micah-breitenstein/MOCO-jib/MILESTONES.md

# Project Milestones

## Milestone 1: Speed Control Stabilization - COMPLETE
Date: 2026-04-16

Status:
- Speed issue is fixed and validated in field testing.

What was stabilized:
- Drone/axis speed behavior now responds consistently.
- Core legacy/original feature set remains functional.
- Timelapse and Flowlapse tuning can proceed on a stable speed baseline.

Why this matters:
- This milestone removes the primary blocker to reliable motion tuning.
- Future work can focus on refinement (smoothing, sync, UX) instead of baseline control recovery.
