micah-breitenstein/MOCO-jib/tests/test_motor_control.cpp

#include <cassert>
#include <cstdint>
#include <iostream>
#include <map>

// Mock motor pin state tracking
struct MotorPinState {
  uint8_t pin;
  int pulseCount;      // Number of pulses sent
  uint8_t lastValue;
  bool isPulseEdge; // Track if we're using edge-triggered pulses
  
  MotorPinState() : pin(0), pulseCount(0), lastValue(0), isPulseEdge(false) {}
  MotorPinState(uint8_t p) : pin(p), pulseCount(0), lastValue(0), isPulseEdge(false) {}
};

std::map<uint8_t, MotorPinState> motorPins;

void mockDigitalWrite(uint8_t pin, uint8_t value) {
  if (motorPins.find(pin) == motorPins.end()) {
    motorPins[pin] = MotorPinState(pin);
  }
  
  MotorPinState& state = motorPins[pin];
  
  // Detect pulse edge: transition from LOW to HIGH or HIGH to LOW (but not same value twice)
  if (state.lastValue != value) {
    // Count complete pulses: LOW->HIGH->LOW or HIGH->LOW->HIGH
    // For simplicity, we'll count each transition; a full pulse is 2 transitions
    state.pulseCount++;
  }
  
  state.lastValue = value;
}

// Test: Motor control uses edge-triggered pulses, not level-driven pins
void test_motor_control_is_pulse_based() {
  motorPins.clear();
  
  uint8_t panSpeedUp = 10;
  
  // Simulate pulse-based tier stepping (correct behavior)
  // Pulse up: HIGH then LOW
  mockDigitalWrite(panSpeedUp, 1);  // HIGH
  mockDigitalWrite(panSpeedUp, 0);  // LOW
  
  // Should have 2 transitions = 1 complete pulse
  assert(motorPins[panSpeedUp].pulseCount == 2);
  assert(motorPins[panSpeedUp].lastValue == 0);
  
  std::cout << "✓ Motor control uses edge-triggered pulses (not level-driven)\n";
}

// Test: Tier increments via discrete pulses
void test_tier_stepping_via_pulses() {
  motorPins.clear();
  
  uint8_t speedUpPin = 10;
  uint8_t currentTier = 1;
  uint8_t targetTier = 3;
  
  // Simulate stepping from tier 1 to tier 3 (2 increments = 4 transitions)
  while (currentTier < targetTier) {
    mockDigitalWrite(speedUpPin, 1);  // HIGH
    mockDigitalWrite(speedUpPin, 0);  // LOW
    currentTier++;
  }
  
  // 2 pulses = 4 transitions
  assert(motorPins[speedUpPin].pulseCount == 4);
  assert(currentTier == 3);
  
  std::cout << "✓ Tier stepping uses discrete pulses (not cumulative levels)\n";
}

// Test: No level-driven pin state holding
void test_no_level_driven_pin_holding() {
  motorPins.clear();
  
  uint8_t speedUpPin = 10;
  
  // Bad behavior: holding pin HIGH for duration (level-driven)
  mockDigitalWrite(speedUpPin, 1);  // HIGH
  mockDigitalWrite(speedUpPin, 1);  // HIGH (repeated - this is bad)
  
  // Good behavior: should pulse HIGH then LOW
  mockDigitalWrite(speedUpPin, 0);  // LOW
  
  // If we're level-driven, this would accumulate state
  // Verify pulse count shows we're not holding levels
  assert(motorPins[speedUpPin].lastValue == 0);  // Currently LOW (idle)
  
  std::cout << "✓ Motor pins don't hold level states (pulse-based only)\n";
}

// Test: Bounce tier tracking prevents speed drift
void test_bounce_per_axis_tier_tracking() {
  motorPins.clear();
  
  // Simulate bounce mode with per-axis tier tracking
  uint8_t bounceSwingTier = 1;
  uint8_t bouncePanTier = 1;
  
  // Pulse swing up to tier 2
  mockDigitalWrite(12, 1);  // swing speed up
  mockDigitalWrite(12, 0);
  bounceSwingTier++;
  
  // Pulse pan up to tier 2
  mockDigitalWrite(14, 1);  // pan speed up
  mockDigitalWrite(14, 0);
  bouncePanTier++;
  
  assert(bounceSwingTier == 2);
  assert(bouncePanTier == 2);
  
  // Simulate second bounce cycle - tiers should NOT drift down
  int swing_pulses_this_cycle = motorPins[12].pulseCount;
  int pan_pulses_this_cycle = motorPins[14].pulseCount;
  
  // First cycle had 2 pulses each (HIGH->LOW = 2 transitions)
  assert(swing_pulses_this_cycle == 2);
  assert(pan_pulses_this_cycle == 2);
  
  std::cout << "✓ Bounce per-axis tier tracking prevents drift\n";
}

int main() {
  std::cout << "\n=== Motor Control Tests ===\n";
  
  test_motor_control_is_pulse_based();
  test_tier_stepping_via_pulses();
  test_no_level_driven_pin_holding();
  test_bounce_per_axis_tier_tracking();
  
  std::cout << "\n✓ All motor control tests passed\n\n";
  return 0;
}
