micah-breitenstein/MOCO-jib/(commit log)

2026-03-20 Initial commit: camera rig sketches and README
2026-03-21 Clean up PS2 pin define formatting
2026-03-21 camelCase rename: swingLeft, swingRight; fix Button Settings header
2026-03-21 camelCase rename: pan, lift, tilt, focus, switches, timelapse vars
2026-03-21 refactor: use constexpr uppercase DIP switch pin constants
2026-03-21 refactor: use bool DIP switch state flags
2026-03-21 refactor: rename reverse DIP switch flags
2026-03-21 refactor: simplify setup pin initialization
2026-03-21 Refactor: extract axis speed control into helper function
    - Add handleAxisSpeedControl() to manage paired-axis button control
    - Preserves ButtonReleased() edge-triggered semantics
    - Consolidates R1/R2 (lift+tilt) and L1/L2 (pan+swing) speed controls
    - Improves readability and maintainability
2026-03-21 Add setDirectionalOutput() helper for reversal logic
    - Consolidates the reversal if-pattern into reusable function
    - Takes reversal flag, normal pin, reversed pin, and desired state
    - Makes reversal logic more readable and maintainable
2026-03-21 Step 4: Extract solo mode handler function
    Adds handleSoloDirectionalMode() to consolidate SELECT+button activation/release pattern
    - Eliminates separate if blocks for each solo direction
    - Manages mode state and pin control in one function
    - Reduces swing solo mode code from 22 lines to 2 function calls
2026-03-21 Step 5: Extract combined mode handler for dual-axis control
    Adds handleCombinedDirectionalMode() to manage button+release for paired axes
    - Consolidates activate/release for 2 axis pairs (swing+pan, or lift+tilt)
    - Manages solo mode check and motion state
    - Reduces swing+pan combined code from 30 lines to 2 function calls
2026-03-21 Step 27: Add detailed timelapse mode Serial.println labels
2026-03-21 Step 29: Restore timelapse mode comments inside switch cases
2026-03-21 Step 31.3: Extract shared bounce stage 0 helpers
2026-03-21 Step 31.4: Extract shared bounce stage 1 helper
2026-03-21 Step 32: Convert bounce MOCO to non-blocking millis state machine
2026-03-21 Refactor NANO_slave_1_SWING: const pins, STAGE_DELAYS array, stepMotor/updateSpeedStage helpers, remove unused vars, add comments
2026-03-21 Refactor NANO_slave_2_PAN: const pins, STAGE_DELAYS array, stepMotor/updateSpeedStage/applySpeedAdjust helpers, add header comment
2026-03-21 Refactor NANO_slave_3_LIFT: const pins, STAGE_DELAYS array, stepMotor/updateSpeedStage helpers, remove unused vars and dead potentiometer, add comments
2026-03-21 Refactor NANO_slave_4_TILT: const pins, STAGE_DELAYS array, stepMotor/updateSpeedStage/applySpeedAdjust helpers, add header comment
2026-03-21 Refactor NANO_slave_5_FOCUS: const pins, STAGE_DELAYS array, stepMotor/updateSpeedStage helpers, add comments
2026-03-22 Step 40: Add stepDist controller adjustment and clamp to 20..150 ms
2026-03-23 Step 51: Settings replay chains interval then stepDist rumble patterns
2026-03-23 Step 52: Print boot-time interval and stepDist to Serial on startup
2026-03-23 Step 54: Print descriptive mode label to Serial on timelapse and bounce start
2026-03-23 Step 59: Add Serial.begin(9600) to setup — Serial output was never initialized
2026-03-23 Step 60: Fix detectControllerType to use println (were missing newlines)
2026-03-23 Step 61: Print timelapse mode label only on first cycle, not every interval
2026-03-23 Step 63: Fix handleFocusAxis duplicate pin — SQUARE and CIRCLE each control one speed pin
2026-03-23 Step 71: Add VS Code build task using arduino-cli for Mega master
2026-03-23 Step 72: Add VS Code Arduino extension recommendations
2026-03-23 Add per-axis deadband calibration for drone stick control
2026-03-23 Print drone tuning profile values at boot
2026-03-23 Print drone modifier and tier threshold config at boot
2026-03-24 Add drone-mode Flowlapse waypoint preview and safe capture run
2026-03-24 Document Flowlapse drone controls and safety behavior
2026-03-24 Tune Flowlapse for safer night motion profile
2026-03-24 Reject near-duplicate Flowlapse waypoints by minimum separation
2026-03-24 Add L1+R1 Flowlapse waypoint clear combo in drone mode
2026-03-24 Add periodic Flowlapse capture progress telemetry
2026-03-24 Print Flowlapse tuning constants in boot serial profile
2026-03-24 Use L2+R2 to delete last Flowlapse waypoint instead of clearing course
2026-03-24 Make L2+R2 a two-step Flowlapse undo then delete action
2026-03-24 README: promote Flowlapse to top-level feature; update L3 button table entry
2026-03-24 Print waypoint axis positions to serial on L3 record
2026-03-24 Add FLOWLAPSE_LOOP_CAPTURE constant to auto-restart capture on completion
2026-03-24 Print DIP axis reversal state to serial at boot
2026-03-24 README: document 5 new Flowlapse features from recent commits
2026-03-24 Add Flowlapse waypoint jog: D-pad left/right steps through waypoints in ready states
2026-03-24 Add FLOWLAPSE_WAYPOINT_DWELL_MS: settle pause at each waypoint before camera trigger
2026-03-24 Make Flowlapse dwell controller-adjustable: SELECT+D-pad UP/DOWN in drone mode (250ms steps, 0-5000ms)
2026-03-24 README: document Flowlapse waypoint jog and controller-adjustable dwell controls
2026-03-24 Improve Flowlapse jog feedback with waypoint current/total indexing
2026-03-24 Add FLOWLAPSE_PREVIEW_SPEED_SCALE to run preview slower than capture
2026-03-24 Add ETA seconds to periodic Flowlapse capture progress logs
2026-03-24 Add L3 hold quick reset in drone mode and document new Flowlapse upgrades
2026-03-25 Add Catmull-Rom curved path mode for Flowlapse capture
2026-03-27 fix: turn off LED_BUILTIN at end of stepMotor() on all Nano slaves
    LED was only cleared at the top of loop(), so at high motor speeds it
    burned solid instead of blinking per pulse. Adding the LOW write at the
    end of stepMotor() makes each step a discrete visible blink, which helps
    distinguish 'moving fast' from a stall or other issue.
2026-03-30 fix: make shoulder speed outputs level-driven on Mega
    Write L1/L2/R1/R2 speed pins from live button state each loop instead of
    relying on ButtonReleased edges. This prevents stale HIGH outputs and
    restores reliable rising-edge speed cycling on Nano slaves.
2026-03-30 fix: make focus wheel outputs level-driven on Mega
    Drive focus direction and speed pins from live button state each loop
    instead of relying on release-edge events. This prevents stale outputs
    and restores responsive focus control after refactor.
2026-03-30 fix: make swing/lift coupled follow outputs level-driven
    Update solo and combined directional handlers to drive outputs from live
    button state each loop instead of release-edge transitions. This avoids
    stale direction pins that can break pan-follow during swing and tilt-
    follow during lift.
2026-03-30 refactor: make generic button direction helper level-driven
    Update handleButtonDirection() to derive pin outputs from live button state
    instead of release-edge events for consistency with other hardened input
    paths.
2026-03-30 fix: allow START to recover from stuck Flowlapse preview
    during Drone Flowlapse, pressing START while preview is running now
    forces preview completion and transitions to READY_FOR_CAPTURE. Added
    README notes describing this recovery path and follow-up START behavior.
2026-04-02 fix: restore shoulder and focus speed button behavior
2026-04-02 hardening: neutralize motor outputs on controller early-exit paths
2026-04-02 feat: add START+R1 return-to-start combo for Flowlapse
2026-04-02 feat: add pause/resume Flowlapse capture via START button
2026-04-02 docs: document pause/resume Flowlapse capture feature
2026-04-02 feat: add runtime ping-pong loop mode toggle for Flowlapse
2026-04-02 feat: add runtime acceleration profile cycling for Flowlapse
2026-04-02 docs: clarify onboard LED is single-color and RGB requires external LED
2026-04-07 Fix: Convert speed control outputs from edge-triggered to live-state polling
    - handleAxisSpeedControl(): Changed from Button/ButtonReleased paired logic to continuous state polling
    - handleFocusAxis(): Changed focus speed pins (SQUARE/CIRCLE) to live-state output
    - Reason: ButtonReleased() events can be missed if loop execution is skipped by early returns, causing speed pins to latch HIGH indefinitely
    - Solution: Write output state every loop based on current button state, eliminating event-dependency
    - Result: Speed control now reliable regardless of execution flow paths
2026-04-07 Refactor: Convert mode selection buttons from edge-triggered to live-state tracking
    - updateTimelapseModeSelection(): Track SELECT button state each loop, detect falling edge
    - updateBounceModeSelection(): Track START button state each loop, detect falling edge
    - Added global bool variables: lastSelectButtonState, lastStartButtonState
    - Reason: ButtonReleased() events can be missed if loop execution is skipped by early returns
    - Solution: Detect edges from live button state, mirroring pattern from speed control fix
    - Result: Mode selection now reliable regardless of loop execution flow
2026-04-07 Refactor: Eliminate remaining ButtonReleased event-dependencies across all button handlers
    Refactored 8 handlers: TRIANGLE, L3, PAD_RIGHT, PAD_LEFT, SELECT(drone), START(drone), R3, and bounce L3
    All button handlers now use live-state polling with edge detection. Immune to early-return path skipping.
    Added documentation to README explaining the architectural decision and benefits.
2026-04-07 Stop tracking ESP32-S3 build artifacts
2026-04-08 Fix Mega speed control handling and startup stage defaults
2026-04-09 Document Mega to ESP32-S3 wiring
2026-04-10 ESP32-S3: add temporary controller-error display test hook
2026-04-10 README: add explicit ESP UART RX/TX pin mapping
2026-04-10 ESP32-S3: move display UART to GPIO40/41
2026-04-10 Add ESP32-S3 matrix status node and integrate timeout-based status recovery
2026-04-10 README: update final display and matrix UART pin mapping
2026-04-11 Document optional ESP32-S3 hardware in requirements
2026-04-11 Add ESP32-S3 display entry to repository structure
2026-04-11 Replace RGB LED note with ESP32-S3 matrix recommendation
2026-04-11 Clarify dual ESP32-S3 RGB matrices in feedback layer
2026-04-12 Tidy display UART parser and direction-change logging
2026-04-12 Improve drone UI responsiveness and fix flowlapse capture progress stall
2026-04-12 Improve flowlapse UI/state handling and progress logging
2026-04-12 Add robust flowlapse display telemetry and preview indicators
2026-04-12 Improve drone modifier indicators and flowlapse status telemetry
2026-04-13 Fix speed button handling and tune diagnostic logging
2026-04-13 Refine flowlapse preview UI and L2 boost visibility
2026-04-13 Add PS2 and Mega wiring photo references to README
2026-04-13 Add README-renderable PS2 wiring images
2026-04-14 Tighten README mission and background copy
2026-04-14 Tighten jib letter spacing in lowercase logo
2026-04-14 Tighten jib tracking to match MOCO spacing
2026-04-14 Switch README logo to v14 cache-busting asset
2026-04-14 Switch README to non-oqo logo filename v15
2026-04-14 Clarify VS Code and Arduino CLI prerequisites in README
2026-04-14 Expand RGB Matrix section: UART config, full state/color table
2026-04-14 Add full UART message table for display firmware; fix baud rate typo
2026-04-14 Correct button polling architecture coverage — speed/focus still use ButtonReleased
2026-04-14 Correct ButtonReleased risk assessment: focus direction is real risk, speed pulse is harmless
2026-04-14 Document history of speed button hold-HIGH refactor in bcea0b5
2026-04-17 WIP: touchscreen settings menu - buttons, colors, theme fixes in progress
2026-04-18 fix: correct display color mapping (BGR order + COLOR_16_SWAP)
    - Set LCD_RGB_ELEMENT_ORDER_BGR (display expects BGR, not RGB)
    - Enable CONFIG_LV_COLOR_16_SWAP in sdkconfig (SPI byte order fix)
    - Disable all LVGL themes (default, basic, mono) — not needed
    - Kill theme on display registration as belt-and-suspenders
    - These two fixes resolve the persistent green tint on gray elements
2026-04-18 fix: editor UI - full ASCII font, value refresh, button layout
    - Regenerate montserrat_120 with full ASCII range (digits, units, symbols)
    - Rebuild settings list on editor close so values reflect changes
    - Fix +/- button positions for display orientation
    - Replace LV_SYMBOL_MINUS/PLUS with plain ASCII characters
2026-04-18 Custom logo image, SAVE/EXIT editor, reset confirm, live settings sync
    - Replace font-based MOCO/jib text labels with embedded logo image (moco-jib-logo-two-line-black.png)
    - Dark and light logo variants for theme switching
    - Upgrade partition table to SINGLE_APP_LARGE to fit embedded images
    - Editor DONE button now prompts Save/Exit confirmation dialog
    - Reset Defaults prompts YES/NO confirmation before resetting
    - Brightness default changed from 80% to 100%
    - Settings list refreshes live when controller changes values via MEGA
    - Editor value label updates in real-time from controller changes
    - Suppress overlay messages when settings panel is visible
    - Fix YES/NO and SAVE/EXIT button positi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
2026-04-18 Fix settings menu crashes and improve UX
    - Fix use-after-free crash: use lv_obj_del_async for confirm panels
    deleted from their own button callbacks (SAVE/EXIT, YES/NO)
    - Fix thread-safety crash: defer settings list rebuild from UART task
    via settings_refresh_pending flag, processed in LVGL task
    - Fix dangling selected_row pointer on list rebuild
    - Settings rows require long-press to open editor (LV_EVENT_LONG_PRESSED)
    - Instant orange highlight on row press (LV_STATE_PRESSED style)
    - Persistent orange selection on release
    - Wider/taller setting rows (80px height) for easier touch
    - Longer hold time to close settings (1000ms vs 500ms to open)
    - Block row interaction until finger lift aft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
2026-04-18 feat: orange matrix LED indicator during settings menu
    - Display sends SETTINGS:OPEN/CLOSE via UART on menu open/close
    - MEGA relays SETTINGS: commands to matrix via Serial2
    - Matrix fills solid orange (255,120,0) while settings active
    - Matrix tracks status changes during settings for proper restore
    - Emergency stop still overrides settings orange
    - Status timeout blocked while settings menu is open
2026-04-18 polish: settings menu UX improvements
    - Deeper orange on matrix LED (255,50,0) and display row highlight (230,110,0)
    - Larger settings row font (Montserrat 40 limited charset, ~20KB)
    - Group headers bumped to Montserrat 48 for visual hierarchy
    - Disable horizontal scroll on settings panel
    - Long-press in editor returns to settings list instead of logo
2026-04-18 polish: settings menu visual refinements
    - Remove SETTINGS title (self-explanatory)
    - Category headers with orange left accent bar
    - Value labels in light orange, switch to white when row selected
    - Fix missing K glyph in limited font (DARK was truncated)
2026-04-19 v1.2-ui-polish: outline button themes, mirror-aware press feedback, border fix
    - All buttons use consistent outline themes:
    - Orange (Close/DONE/SAVE): dark bg, orange border, orange text, fill on press
    - Red (Reset Defaults/YES): dark bg, red border, red text, fill on press
    - Gray (+/-/CANCEL/NO on save dialog): dark bg, gray border, white text, fill on press
    - btn_press_ctx_t struct + outline_btn_press_cb for reusable press/release visual feedback
    - set_border_all_states() helper: sets border on all 6 LVGL states to prevent border clearing
    - Cross-wired press callbacks on mirrored confirm dialogs (SAVE/CANCEL, YES/NO, +/-)
    - Swapped Close above Reset Defaults in settings list footer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
2026-04-19 v1.3-slideable-touch: panel-level touch for all button pairs
    - confirm_touch_cb handles PRESSED/PRESSING/RELEASED/PRESS_LOST at panel level
    - point_in_obj + highlight_btn helpers for real-time finger tracking
    - Save/Cancel, YES/NO confirm dialogs: buttons non-clickable, panel owns touch
    - +/- editor buttons: same slideable pattern with LONG_PRESSED_REPEAT
    - Sliding between buttons updates highlight and fires correct action on release
2026-04-19 v1.4-ui-tweaks: color updates and bug fixes
    ESP32-S3 Display:
    - Emergency stop now closes settings menu and reverts editor values
    - Timelapse/Bounce mode text shows variant descriptions, persists on screen
    - Flowlapse progress bar: blue -> orange (200,120,40)
    - Joystick stick-press indicators: green -> red (255,50,50)
    - Boost/Precision modifier indicators: blue -> green (0,255,0)
    MEGA:
    - Framecount rumble durations increased (long 1000ms, short 450ms)
    - Boost indicator now updates in all flowlapse states (preview, capture, paused)
2026-04-19 v1.5-purple-theme: purple color scheme for drone mode
    - Joystick stick-press indicators: red -> light purple (200,100,255)
    - Boost/Precision modifier boxes: green -> purple (160,50,255)
    - Flowlapse progress bar: horizontal gradient purple (100,0,255) to pink-purple (220,50,220)
2026-04-20 v1.6-settings-mode: controller settings nav, D-pad, rumble feedback
    - L3 toggles settings mode (blocked in drone mode)
    - D-pad UP/DOWN navigates settings list with auto-repeat (400ms/150ms)
    - D-pad LEFT/RIGHT adjusts editor values with auto-repeat
    - Circle selects/saves, X cancels/backs out
    - Settings mode: motors stopped, only settings input active
    - Touch long-press also enters settings mode on MEGA (synced via UART)
    - Matrix LED goes orange on settings open (both touch and controller)
    - Save rumble feedback for numerics (via adjustInterval/adjustStepDist)
    - Save rumble for booleans (via SETTINGS_SAVED message)
    - Emergency stop clears settings mode
    - Purple theme: boost/precision purple, f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
2026-04-22 v1.9 flowlapse pause timing fix, all-board upload tasks
    - MEGA: track paused wall-clock time (flowlapseTotalPausedMs/flowlapsePauseStartMs)
    so elapsed time and status bar do not jump on resume
    - MEGA: shift flowlapseCapturePhaseStartMs forward on resume to keep
    segment progress accurate
    - .vscode/tasks.json: correct serial ports for all three boards,
    add Matrix and Display build/flash tasks
    - main.c, matrix .ino: uncommitted post-v1.8 changes (5% boot brightness,
    0-100 range, constant white idle, 1% steps)
    Closes #8
    Closes #9
2026-04-22 fix #12: set 16MB flash + custom partition table for Waveshare display
    - sdkconfig.defaults: flash size 16MB, custom partitions.csv, font_28 added
    - partitions.csv: 6MB app partition (was 1.5MB), 8MB spiffs storage
    - CMakeLists.txt: pin IDF_TARGET=esp32s3 to prevent wrong-target regen
    - Binary now 25% of partition (75% free) instead of 99%
    Root cause: sdkconfig had FLASHSIZE_2MB despite board having 16MB.
    After fullclean the wrong default esp32 target also caused GPIO 40-48
    to be undeclared (exposed pre-existing fragility fixed by pinning target
    in CMakeLists.txt and adding missing font_28 to sdkconfig.defaults).
    Closes #12
    [partitions.csv]
2026-04-22 v1.10 axis home/zero core + display UI + headless docs
    - MEGA: PersistedSettingsV4 with home pose (swing/lift/pan/tilt floats)
    - MEGA: set/go/clear home combos (START+TRI/SQ/CIR in drone mode)
    - MEGA: handleHomeReturnStep reuses flowlapse motion toward pose
    - MEGA: HOME:* status broadcasts for all home events
    - MEGA: processDisplayCommands handles SET:HOME_SET/GO/CLEAR
    - MEGA: V3->V4 EEPROM migration preserves existing settings
    - Display: STYPE_ACTION type, Set/Go/Clear Home action rows
    - Display: HOME:* status events -> temporary overlay messages
    - Display: NVS skip guard for action-type settings
    - README: Headless Operation section with home combos, ref #11
    - .vscode/tasks.json: correct se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
2026-04-22 fix #15: restore correct display color byte order after rebase
    - Pin CONFIG_LV_COLOR_16_SWAP=y in sdkconfig.defaults
    - Keep theme defaults disabled to preserve existing UI styling
    - Regenerated sdkconfig from defaults and reflashed display
    Root cause: LVGL RGB565 byte-swap flag was turned off during config regeneration,
    causing incorrect color channel ordering on panel output.
2026-04-22 fix #16: enable settings access in drone mode
    - remap settings toggle to START+SELECT hold instead of L3
    - allow settings access while drone mode is active
    - move Set/Go/Clear Home into a dedicated ZEROING section on display
    - document current modal settings/home-return behavior in README
    Also restores missing home-set combo state tracking needed for Mega build.
2026-04-22 fix: add Nano LED confirmation for speed stage changes
    - pulse onboard LED when speed change input is received
    - keep implementation lightweight and non-blocking
    - apply consistently across all five Nano axis controllers
    Fixes #4
2026-04-23 fix #17: restore bounce L3 flow by blocking settings toggle during auto modes
    Refs #4 (Nano LED speed-change confirmation already included on this branch in fa065c1).
2026-04-23 fixes #2: restore drone stick speed behavior and add stick-speed mode toggle
    - stop stick-center speed ratcheting that dropped Nano stages over repeated cycles\n- add START+SELECT+CROSS toggle for proportional vs fixed joystick speed in drone mode\n- add guarded manual shutter trigger on R1 in drone mode
2026-04-23 Normalize axis speed stage when exiting auto modes
    Prevents stage carryover from timelapse/bounce into subsequent manual or bounce runs by re-homing motion axes to DEFAULT_AXIS_SPEED_STAGE during reset of active auto modes.
2026-04-23 Add timelapse max speed stage cap feature with display command support
    Allows runtime tuning of max speed stage (1-4) to adjust motion smoothness for different payload weights. Implemented with display command support (SET:TL_MAX_STAGE:<1-4>) for no-reflash configuration. Updated README with timelapse tuning constants guide.
2026-04-23 Add runtime anti-backlash controls for timelapse
    Adds anti-backlash preload phase with runtime toggle via controller combo (START+SELECT+R1) and display/serial command support (SET:TL_BACKLASH:<0|1>). Also wires timelapse max speed stage adjustment handler into loop, updates timing budget math, and refreshes README controls/docs.
2026-04-23 Fix drone speed state and wire precision micro-motion ratio
    Resets drone speed baseline on mode entry, forces STOP tier at stick center, restores visible boost impact across all drone axes, documents START+SELECT+X stick-speed toggle, renames L2/R2 priority constant for clarity, and implements DRONE_MICRO_MOTION_SPEED_RATIO as precision-mode duty-cycle scaling.
2026-04-23 Add bounce endpoint speed ramping for cleaner reversals
    Introduces bounce speed-tier ramp profile with endpoint stop band and configurable ramp window, applies per-mode speed tier control during stage 1 motion, and forces stop tier at endpoint transition for smoother turnaround.
2026-04-24 Nano slaves: add direction-safe ramping and pending-stop decel flow
2026-04-24 Tighten drone stick deadbands for finer control
2026-04-24 Add regression test suite: trigger polarity, direction mappings, motor control
2026-04-25 Fix: reset touch timer on release so first tap uses 1x (not 10x)
2026-04-25 Fix: reset dpad acceleration on direction change or button release gap
2026-04-25 Fix: isolate touch/dpad acceleration tracking (clear inactive input timer)
2026-04-25 Fix: keep dpad turbo stable during hold despite cmd jitter
2026-04-25 Chore: update device task ports and remove Mega rumble debug logging
2026-04-26 Remove ESP32-S3 (to be replaced with submodule)
    [partitions.csv]
2026-04-26 Remove ESP32-S3-Matrix (to be replaced with submodule)
2026-04-26 Add MOCO-stepper submodule; remove NANO axis sketches from root
2026-04-26 Update MOCO-stepper submodule to Arduino library layout
2026-04-26 Update MOCO-stepper submodule (README added)
2026-04-26 Update MOCO-stepper submodule (README Nano flash steps)
2026-04-26 Update MOCO-stepper submodule (README clarification)
2026-04-26 Update MOCO-stepper submodule (speed-stage LED blink)
2026-04-26 Update MOCO-stepper submodule (debugging docs)
2026-04-26 Update MOCO-stepper submodule (pin mapping docs)
2026-04-26 Update MOCO-stepper submodule (complete pin mapping)
2026-04-29 chore: update MOCO-control and MOCO-matrix submodules (flowlapse purple breathing)
2026-05-05 chore: update MOCO-control submodule (drone direction pin fix, closes #21)
2026-05-05 Update MOCO-control submodule (boost jitter fix, closes #22)
2026-05-06 feat: Night Mode setting for display and matrix
    Closes #28
    - Night Mode toggle in BRIGHTNESS settings group
    - ON: display → 10%, matrix → 0%
    - OFF: display → 100%, matrix → saved value
    - State resets to OFF on power cycle (not persisted)
2026-05-06 feat: WiFi AP web event console
    Closes #29
    - ESP32-S3 hosts AP: 'MOCO Jib' / openjib1
    - Dark event console at http://192.168.4.1 with live WebSocket feed
    - Events: boot, mode changes (with variant detail), settings, home actions, night mode
2026-05-07 fix: display backlight on at boot, accurate event timestamps
    Closes #30
    - Display now turns on at 100% brightness on every boot
    - Web console events carry ESP32 uptime timestamp (not browser receive time)
    - Mode event flooding debounced to suppress burst from rapid UART messages
2026-05-12 Add bounce web page and control interface
    - Created bounce.html with 8 mode cards (Swing Left+Boom Down/Up, Swing Right+Boom Up/Down, Swing Left, Boom Up, Swing Right, Boom Down)
    - Registered /bounce route in web_console.c with page handler and PAGE:BOUNCE support
    - Added PAGE_TYPE_BOUNCE enum for event filtering
    - Updated navigation menus in landing.html, timelapse.html, settings.html to include bounce link
    - Added bounce.html to CMakeLists.txt embedded files
    - Implemented SET:BOUNCE_START and SET:BOUNCE_STOP commands in MEGA firmware
    - Follows same activation pattern as timelapse with modal confirmation and stop button
    - Monitors MODE:BOUNCE status messages for UI state updates
    Resolves h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
2026-05-12 Add web-based bounce duration control
    - MOCO-display: Added duration slider UI to bounce.html
    - MOCO-control: Added SET:BOUNCE_DURATION command handler
    - Allows full bounce setup from web without physical controller
    - Duration range: 150-5000ms with 50ms steps
    - UI shows Stage 0 guidance and hides duration control in Stage 1
2026-05-13 Update submodules: Add drone mode web interface with joystick visualization and camera trigger
2026-05-14 Update submodules: Settings sync and mode persistence fixes
    MOCO-display (42ebe5d → 3a6b906):
    - Add web_console_broadcast_setting() for direct SETTINGS: broadcasts
    - Broadcast MODE: and CONTROL: messages to WebSocket clients
    - Add broadcast_setting_update() calls when ESP display changes settings
    - Fix bounce/timelapse STOP commands
    - Fix WebSocket CONNECTING state errors
    MOCO-control (37a9e36 → f165b5e):
    - Add STATUS_REQUEST handler for mode state restoration
    Fixes:
    - Settings changes on ESP display now update web settings page
    - Active bounce/timelapse mode persists when navigating between pages
    - Stop buttons work correctly
    - No more WebSocket race condition errors
2026-05-15 Update submodules and add stepper DIR pin test
    Submodule updates:
    - MOCO-display: Add PCF85063 RTC support for drift-free timekeeping
    - MOCO-control: Fix flowlapse preview to properly reverse through waypoints
    New diagnostic tool:
    - test_dir_pin.ino: Simple test to verify stepper DIR pin toggles (for troubleshooting one-direction motor issues)
    [test_dir_pin.ino]
2026-06-08 Track holy-grail-timelapse submodule
